jasonacox/ATtiny85-Weather-Station/kicad/ATtiny85 Weather Station.kicad_pcb

## KiCad design kicad/LuminousThing/LuminousThing.sch

Schematic: LuminousThing.sch

Parts:
C1: 100nF
J1: DIN-3
J2: Conn_01x02
JS1, JS2, JS3, JS4: Conn_01x02
Q1, Q2, Q3, Q4: IRLB8721PBF; TO-220-3_Vertical
R1A, R1B, R2A, R2B, R3A, R3B, R4A, R4B: R_US
R3: 10K
U1: ESP-12E
U2: 4016

Notes on the sheet:
Logic + Power Control
In-Circuit USB Serial Programmer
Power Regulation
