jasonacox/ATtiny85-Weather-Station/(commit log)

2020-06-05 Added code to measure pressure rise/fall
2020-06-06 Added schematic
    [ATtiny85 Weather Station.kicad_pcb, ATtiny85 Weather Station.sch]
2020-07-12 Add code to handle steady pressure state
2020-07-13 Updated pressure change + Tiny_BME280 Library
